JoaoSenirio/LEGOEV3_Sensors_NewUsability/README.md

# Sensores Lego EV3: nova possibilidade de uso 


## Resumo 

O presente projeto busca mostrar a possibilidade de uso e de integração dos sensores da coleção LEGO EV3 MINDSTORM com outras plataformas de prototipação/robótica educacional, isto é, intenta o funcionamento do sensores em questão sem o intermédio do controlador principal da coleção, o *brick*. Tal processo demandou a execução de muitas etapas, as quais iniciaram com a análise da documentação oficial da LEGO, passando pela construção da placa adaptadora e por estudos dos *bytes* enviados pelos sensores e encerrou com a programação de um algoritmo — testado nas placas Arduino MEGA/UNO — o qual implementa a comunicação com os sensores, sendo capaz de mantê-la estável e de exportar as leituras feitas por eles. Ao final de todo o processo, provou-se exequível a integração dos sensores da coleção LEGO EV3 MINDSTORM com outras plataformas.

## Motivação

No cenário da tecnologia educacional, as plataformas da LEGO e do Arduino ocupam posições de destaque, sendo que o último também marca presença no mundo maker. Não se pode negar a qualidade dos kits da LEGO, contudo o alto preço para aquisição desses é um fator limitante, enquanto o Arduino é mais acessível. Apesar das vantagens e das desvantagens de cada um, em competições de robótica as duas plataformas tem se destacado. Foi, em uma dessas competições, que minha curiosidade sobre a integração das duas plataformas surgiu. Contextualizando, minha equipe encontrou muita dificuldade para fazer aferições dos símbolos que se encontravam no terreno a ser percorrido pelo robô, sendo que utilizávamos a plataforma da Arduino e sensores compatíveis, enquanto demais equipes optaram pela LEGO e não pareciam encontrar dificuldade para tal tarefa. Mais tarde, passado o evento, percebemos que nossos sensores não eram da melhor qualidade, além da inconsistência nas leituras deles. Não havia me esquecido do sensores da LEGO utilizados por alguns adversários, da qualidade e da facilidade de leitura deles, fatos que notamos a partir de interações com as demais equipes, de maneira que comecei a me questionar sobre a possibilidade de utilizá-los com o Arduino, plataforma com a qual já estava habituado. Após muitas pesquisas, frustrado com a ausência de projetos os quais executassem minha ideia, tomei esse desafio como particular: integrar os sensores da LEGO com outras plataformas microcontroladas, de forma a expandir as possibilidades de uso e tornar isso público para o proveito de todos.

## Detalhes do processo

Inicialmente, em busca de informações técnicas sobre os sensores e sobre toda a coleção LEGO MINDSTORM EV3, foi encontrada ampla documentação — nomeada Developer Kit — fornecida pela própria LEGO, que versa sobre *Firwmare, Hardware e Comunicação*, podendo ser acessada [neste link.](https://education.lego.com/en-us/product-resources/mindstorms-ev3/downloads/developer-kits) As informações mais relevantes para a execução do projeto encontram-se na seção *Hardware*, a qual está anexada ao repositório.

Para o desenvolvimento do projeto, os sensores de toque, luz/cor e infravermelho foram usados nos testes e nas etapas seguintes. Com o intuito de estabelecer conexão física com os sensores, para assim compreender a comunicação entre eles e o *brick* e mais tarde realizá-la sem o *brick*, foi preciso a construção de uma placa adaptadora, a qual contou com o conector específico da coleção EV3: 6 *wire* RJ-12 *right side*. No exterior, tal conector pode ser facilmente encontrado em lojas de varejo, como o AliExpress, porém, no Brasil, apesar da sua comercialização ser mais rara, pode ser encontrado em lojas como a [RoboCore.](https://www.robocore.net/) A placa adaptadora, confeccionada em placa perfurada, surgiu como alternativa à protoboard, uma vez que a robustez e a confiabilidade das ligações na nova montagem cessaram as interferências e a perda de dados.

A placa adaptadora ainda conta com resistor de *pull-up* no pino 1 e de *pull-down* no pino 6. O pino 1 é responsável pela identificação da conexão do sensor e a qual tipo ele pertence, isto é, permite a diferenciação entre o estado de disconectado, de sensor simples conectado ou de sensor digital conectado. Sendo assim, por meio das ligações internas dos sensores relativas ao pino 1 associadas ao resistor de *pull-up* externo, são percebidas distintas tensões entre cada estado — 5 volts para disconectado, 0.42 volts para sensor simples conectado e 0 volts para sensor digital conectado —, as quais, quando tratadas por portas analógicas ou por conversores A/D, permitem a identificação dos sensores. As leituras feitas por eles são enviadas ao controlador principal por meio do pino 6, sendo que o terminal é utilizado para esse fim tanto pelo sensor simples quanto pelo digital. Todavia, o sensor de toque — como sensor simples —, quando não detecta nenhum contato, deixa o pino 6 flutuando, ou seja, sem nenhuma referência de tensão. Visando contornar tal problema, sem promover nenhum tipo de interferência na comunicação do sensor digital, implementou-se um resistor de *pull-down* externo ao pino 6. 

Com a placa montada, o mapeamento dos pinos dela foi realizado seguindo os esquemáticos dos sensores — visando identificar pinos como GND, VCC e UART TX/RX. Com isso, foi possível conectar os sensores digitais ao analisador lógico USB, semelhante a esse do [link,](https://www.usinainfo.com.br/testadores-e-medidores-diversos/analisador-logico-24mhz-8ch-al24-2691.html) permitindo conhecer/analisar os pacotes de dados enviados por eles. Tais pacotes foram interpretados com o auxílio do *software* [Logic 2](https://www.saleae.com/downloads/) (da Saleae), da documentação oficial da LEGO e da documentação do projeto LeJOS, o qual conduziu uma análise do [Protocolo dos Sensores UART.](https://sourceforge.net/p/lejos/wiki/UART%20Sensor%20Protocol/) Maiores detalhes sobre a comunicação UART, capturas do analisador lógico e a interpretação dos pacotes encontram-se na [devida pasta.](https://github.com/JoaoSenirio/LEGOEV3_Sensors_NewUsability/tree/main/Logic%20Analyser%20Captures)

A partir de toda informação até aqui coletada, iniciou-se a programação de um microcontrolador com o intuito de captar e exportar as leituras feitas pelos sensores LEGO EV3. Inicialmente, optou-se pelo ATMega 2560 — embarcado na plataforma do Arduino Mega — para construir o algoritmo principal, uma vez que tal microcontrolador possui inúmeros recursos que facilitam a primeira etapa de codificação, tais como 4 UARTs, 6 timers, além de extensa memória. Peculiaridades técnicas dessa aplicação inicial encontram-se na [respectiva pasta.](https://github.com/JoaoSenirio/LEGOEV3_Sensors_NewUsability/tree/main/Controlling_sensors_1.0_MEGA) A seguir, o algoritmo foi trabalhado a fim de reduzir o uso de memória e melhorar seu desempenho, de forma que foi possível portá-lo para o ATMega 328p — embarcado no Arduino UNO, sendo que detalhes técnicos dessa etapa podem ser conferidos na [devida pasta.](https://github.com/JoaoSenirio/LEGOEV3_Sensors_NewUsability/tree/main/Controlling_Sensors_1.0_UNO) Por fim, a título de exemplo, os vídeos abaixo, mostrando ambas as aplicação em funcionamento, foram produzidos.

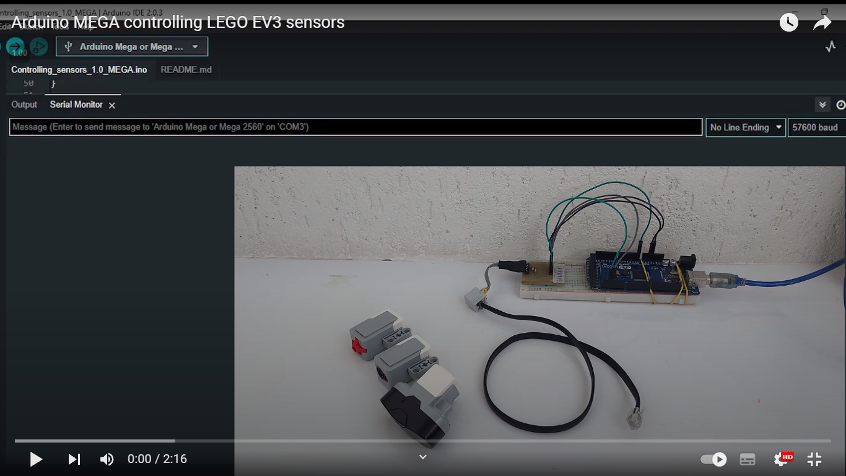
[picture p1: Images/MEGA_Thumbnail.png]
IMAGE ALT TEXT (http://www.youtube.com/watch?v=v17XQr9M2BI "Arduino MEGA controlling LEGO EV3 sensors")


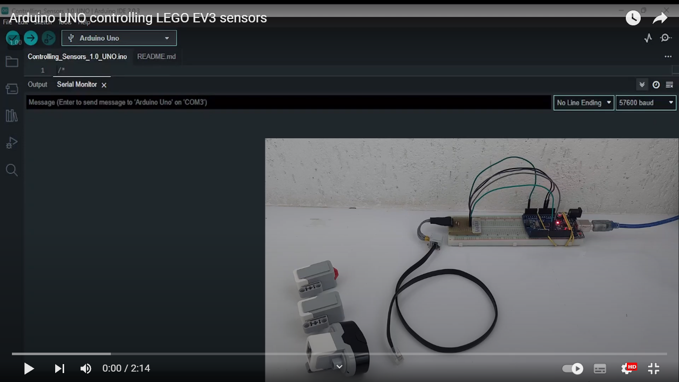
[picture p2: Images/UNO_Thumnail.png]
IMAGE ALT TEXT (http://www.youtube.com/watch?v=nMiRV2qx3uY "Arduino UNO controlling LEGO EV3 sensors")


## Próximos passos

Ainda há muito que pode ser feito, de maneira a aprimorar as funcionalidades e as capacidades do presente projeto. Abaixo, encontra-se uma lista de possíveis/futuros incrementos. Sinta-se livre para contribuir. 

* Expandir para demais sensores da coleção LEGO EV3 MINDSTORM. 
* Construir uma versão em PCB da placa adaptadora, com a possibilidade de incluir um microcontrolador que gerencie o sensor conectado, apenas exportando os dados lidos. 
* Adicionar controle simultâneo de mais de um sensor. 
* Com o microcontrolador dedicado na PCB, construir uma lib para facilitar a integração de controladores externos com placa adaptadora.
