JoaoSenirio/LEGOEV3_Sensors_NewUsability/LEGO MINDSTORMS EV3 Hardware Developer Kit/10. Appendix LEGO MINDSTORMS EV3 large motor hardware schematics.pdf

5 | 4 | 3 | 2 | 1

D

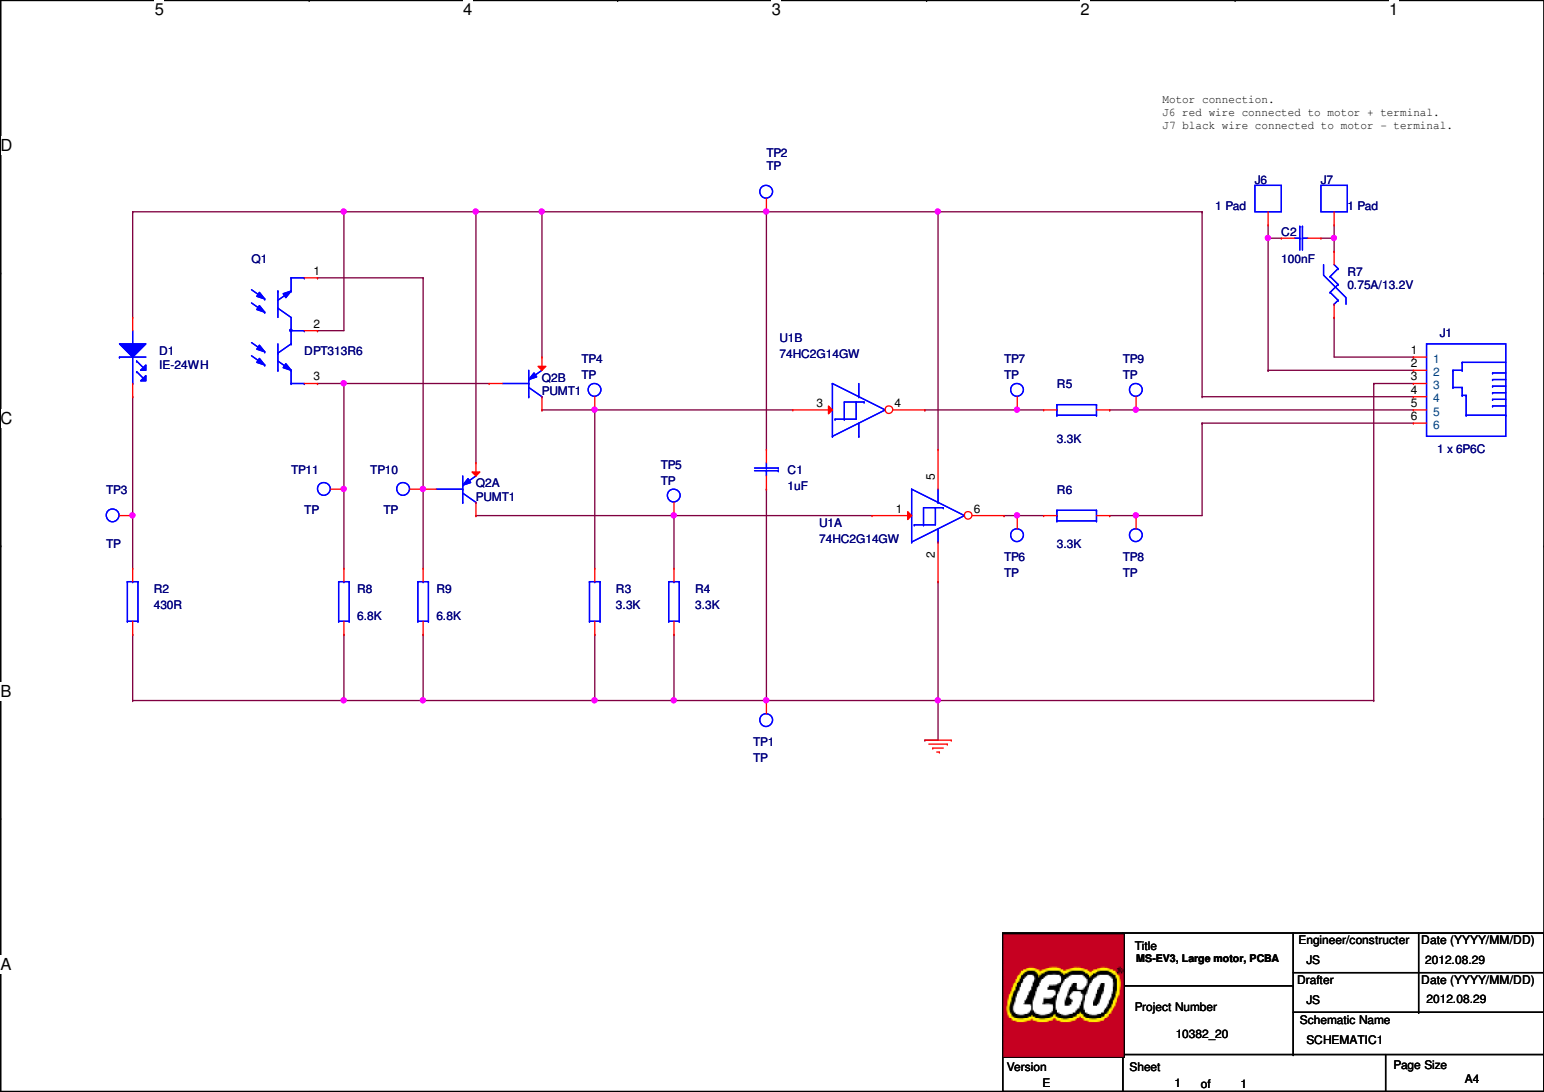
[picture p3: page 1]

Motor connection.
J6 red wire connected to motor + terminal.
J7 black wire connected to motor - terminal.

Date (YYYY/MM/DD)
