JoaoSenirio/LEGOEV3_Sensors_NewUsability/LEGO MINDSTORMS EV3 Hardware Developer Kit/2. Appendix LEGO MINDSTORMS EV3 programmable brick display hardware schematics.pdf

UP

# ACK/ON

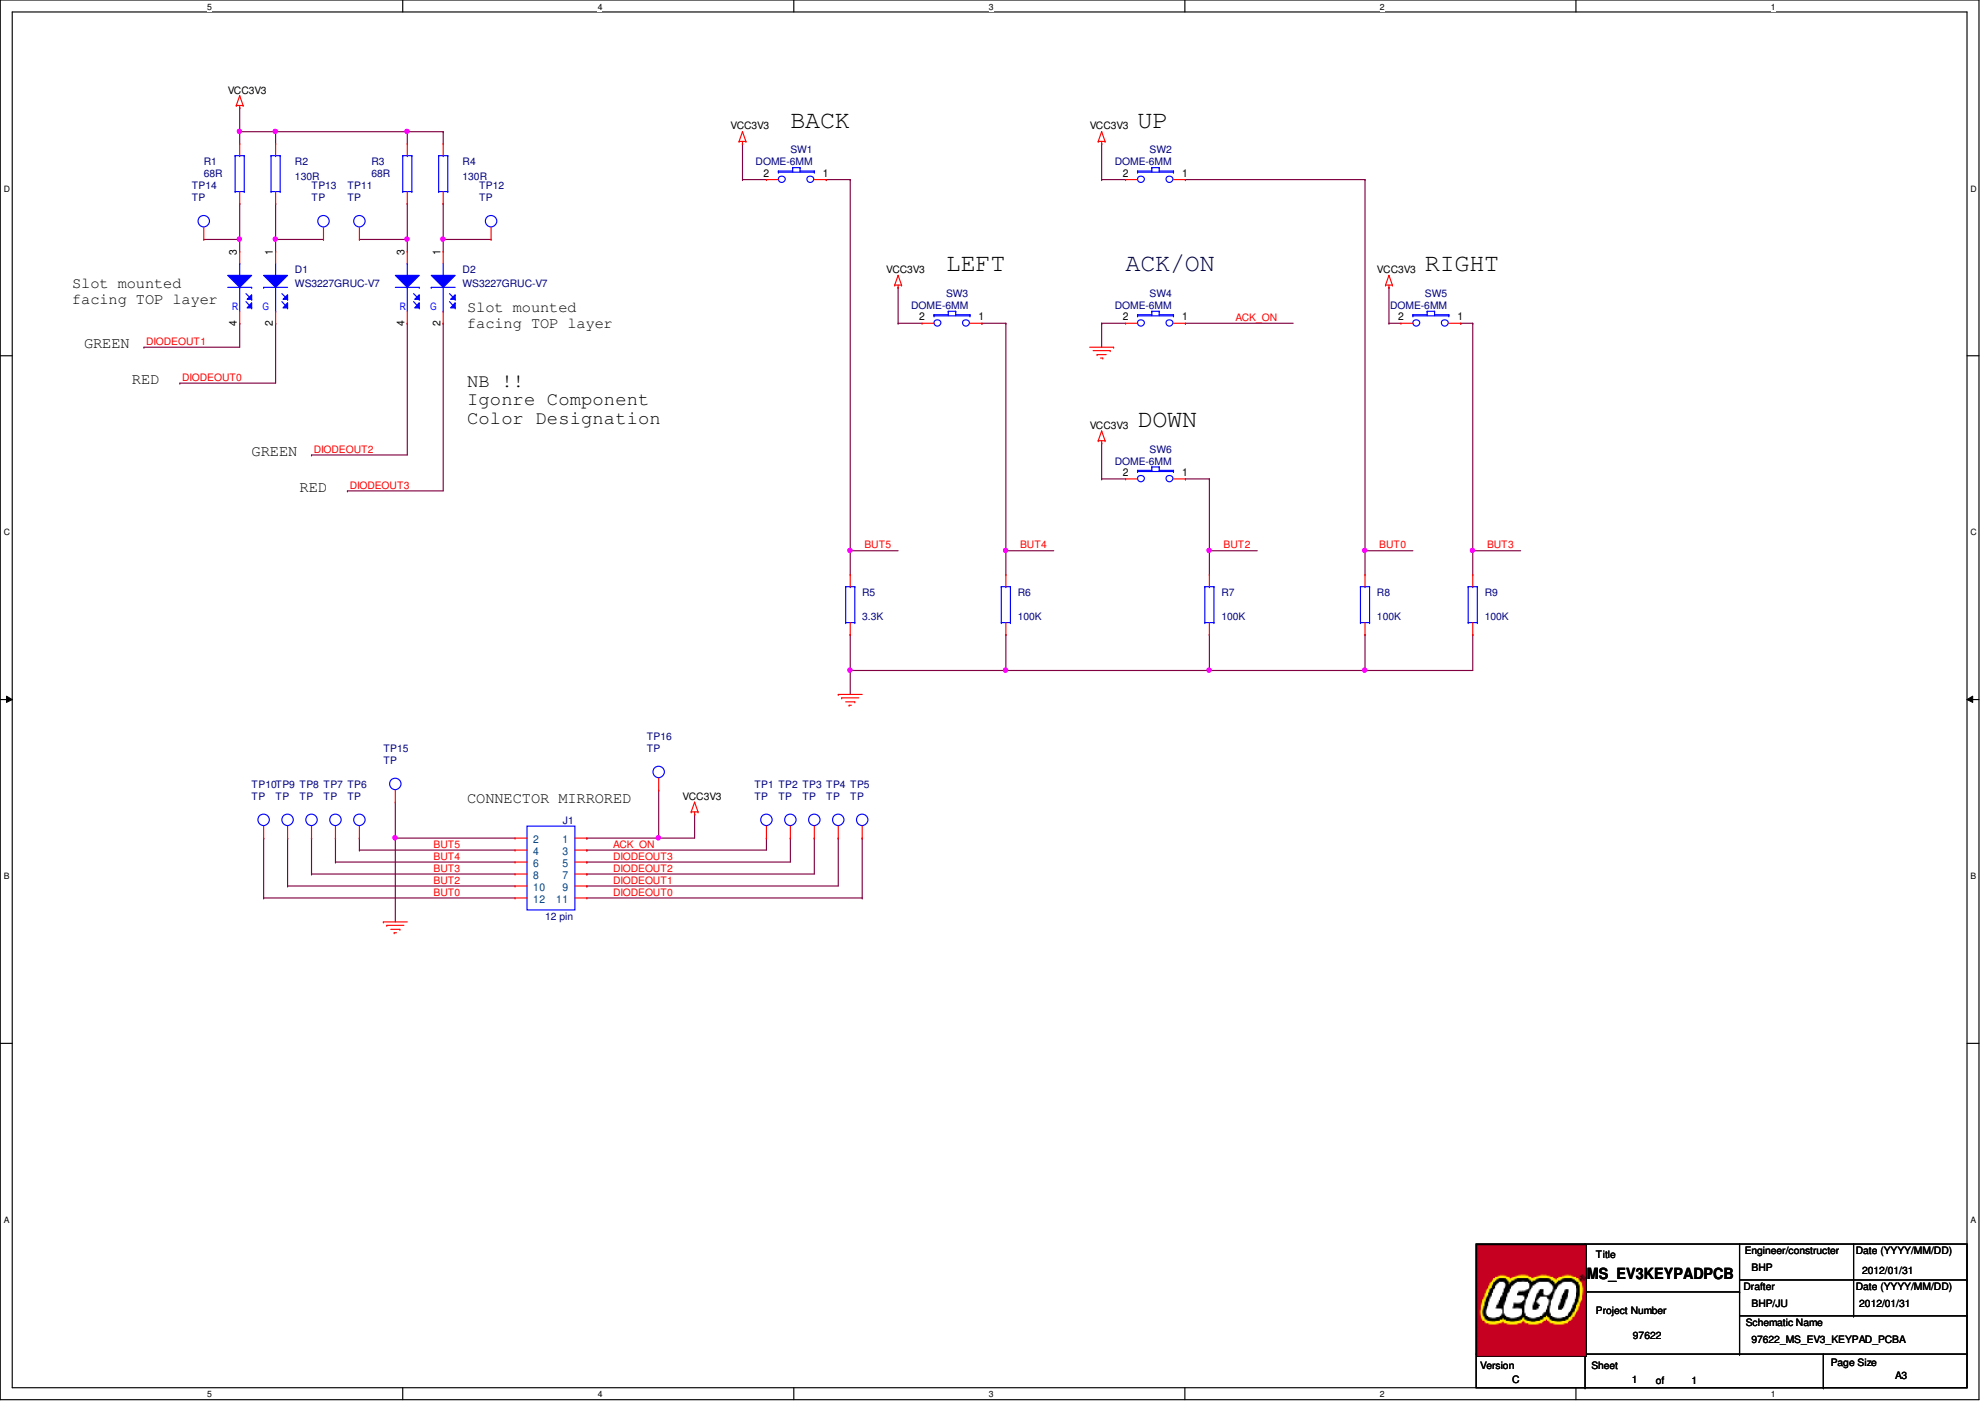
[picture p4: page 1]

Date (YYYY/MM/DD)
