JoaoSenirio/LEGOEV3_Sensors_NewUsability/LEGO MINDSTORMS EV3 Hardware Developer Kit/3. Appendix LEGO MINDSTORMS EV3 touch sensor hardware schematics.pdf

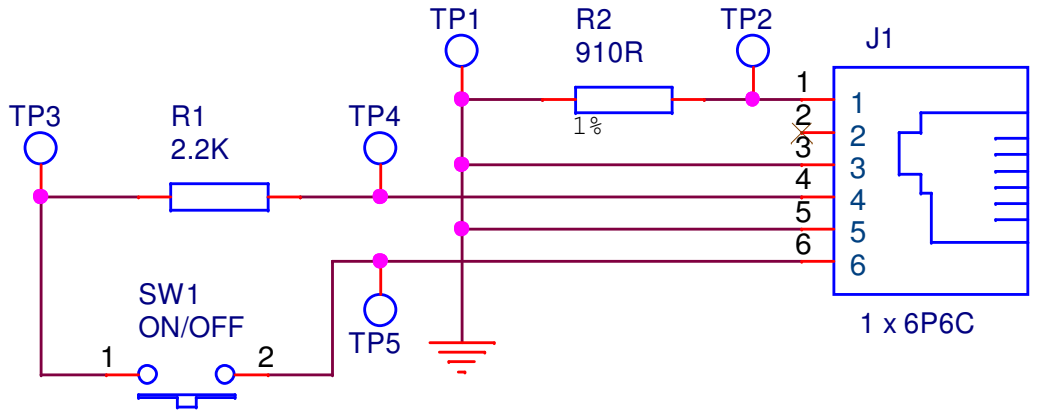
[picture p5: page 1]

Date (YYYY/MM/DD)
