JoaoSenirio/LEGOEV3_Sensors_NewUsability/LEGO MINDSTORMS EV3 Hardware Developer Kit/5. Appendix LEGO MINDSTORMS EV3 infrared seeker sensor hardware schematics.pdf

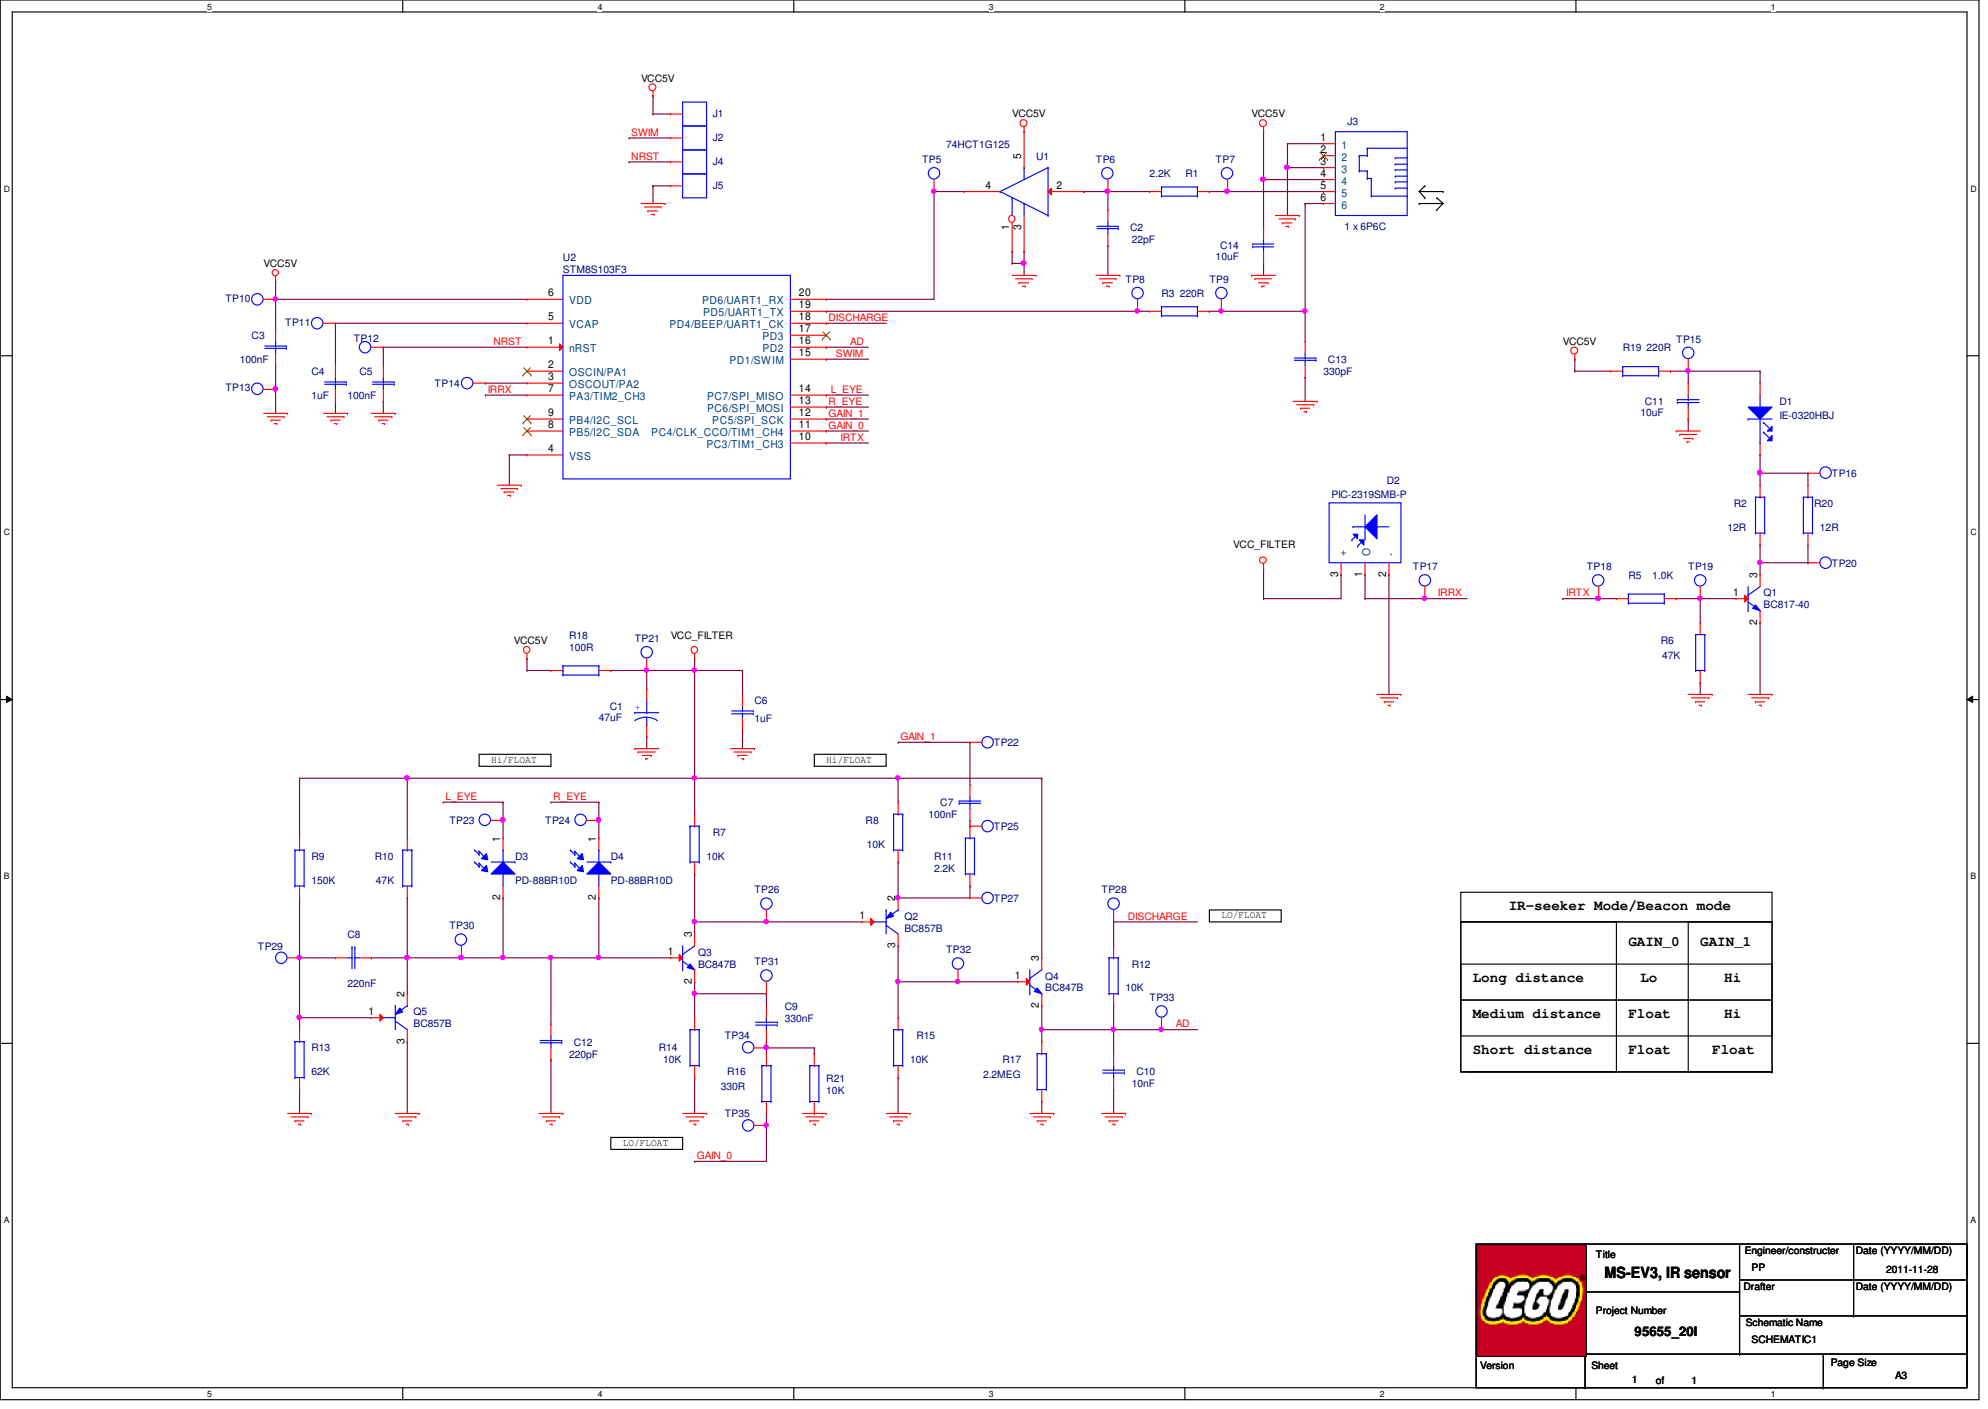
[picture p6: page 1]

IR-seeker Mode/Beacon mode

Date (YYYY/MM/DD)
