JoaoSenirio/LEGOEV3_Sensors_NewUsability/LEGO MINDSTORMS EV3 Hardware Developer Kit/6. Appendix LEGO MINDSTORMS EV3 beacon hardware schematics.pdf

5

4

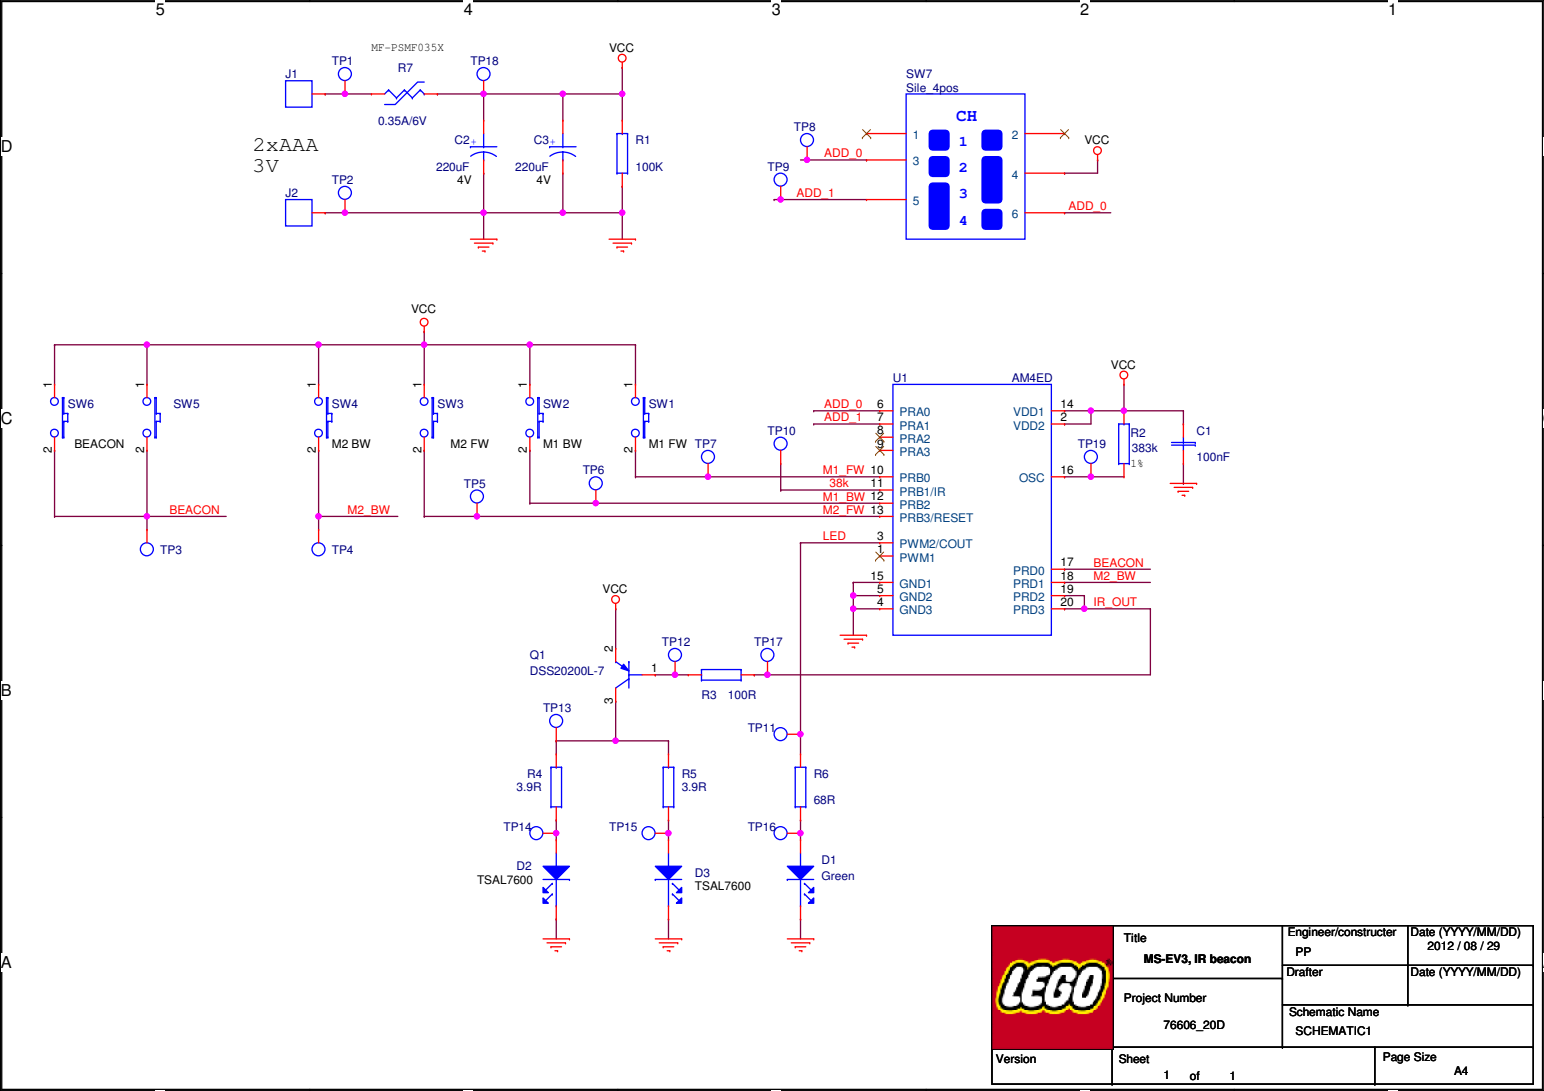
[picture p7: page 1]

Date (YYYY/MM/DD)
