JoaoSenirio/LEGOEV3_Sensors_NewUsability/(commit log)

2022-12-18 Reading LEGO Sensors with Arduino MEGA
2022-12-18 Adding information about the LEGO EV3 connector and its documentation
2022-12-18 Adding information about UART communication
2022-12-18 Adding captures of the initial packet send by the sensors
2022-12-19 Adding interpretation of initial package bytes
    [First_Package - Color Sensor.xlsx, First_Package - IR Sensor.xlsx]
2023-02-05 Reading LEGO Sensors with Arduino UNO
2023-02-05 Alteração: nova flag para identificação do sensor de toque
